hjt8896/STM32-FOC-Driver/Docs/基于 STM32 的有感磁场定向控制.pdf

本文档截选自作者本科毕业论文，仅用于技术交流

## 基于 STM32 的有感磁场定向控制（FOC）系统实现

1.1 引言

磁场定向控制也称 FOC，是一种电机控制方法，本章的设计将使用 FOC 算 法对一个 PMSM 进行矢量控制，在这种控制方式下，电机能够输出很高精度的

力矩和转子位置。

## 1.2 PMSM 数学模型

本节采用旋转坐标系（dq 轴），则 PMSM 的动态特性由公式(1-1)、(1-2)描

述：

d
d | d s | d | e q q

di
v i R L | L i
dt = | + | -ω | (1-1)
( | )

q
q | q s | q | e | d d | f

di
v i R L | L i
dt = | + | +ω | + Ψ | (1-2)
式中 | , d | q v v ——d 轴和 q 轴电压（V）；

, d q
i i ——d 轴和 q 轴电流（A）；

Rs ——定子电阻（Ω ）。

, Ld Lq ——d 轴和 q 轴电感（h）；

## ωe ——电角速度（rad/s）；

Ψ f ——永磁体磁链（Wb）；

对 d

## i 和 q

i 进行前馈解耦：

'd | d | e q q v = v +ω L i | (1-3)
' | ( | )
q | q | e | d d | f v = v -ω L i + Ψ | (1-4)

解耦后的电压方程简化为：

'd
d
d s d

di

## v i R L

dt = | + | (1-5)
' | | q
q | q s | q di

## v i R L

dt = | + | (1-6)

此时，dq 轴电流的传递函数为：

| ' | 1
( )
( )
( ) 1
d | s d
d | d
s i s | R G s
v s | L
s
| R
= | =
+

(1-7)

# 本文档截选自作者本科毕业论文，仅用于技术交流 本文档截选自作者本科毕业论文，仅用于技术交流 本文档截选自作者本科毕业论文，仅用于技术交流

' | 1
( )
( )
( ) 1
q | s q
q | q
s i s | R G s
v s | L
s
| R
= | =
+

(1-8)

### 1.3 磁场定向控制算法架构

FOC 算法主要由 PI 控制器、电流坐标变换、空间矢量 PWM 调制以及转子 位置反馈这几个部分组成，整体控制结构图如图 1-1 所示：

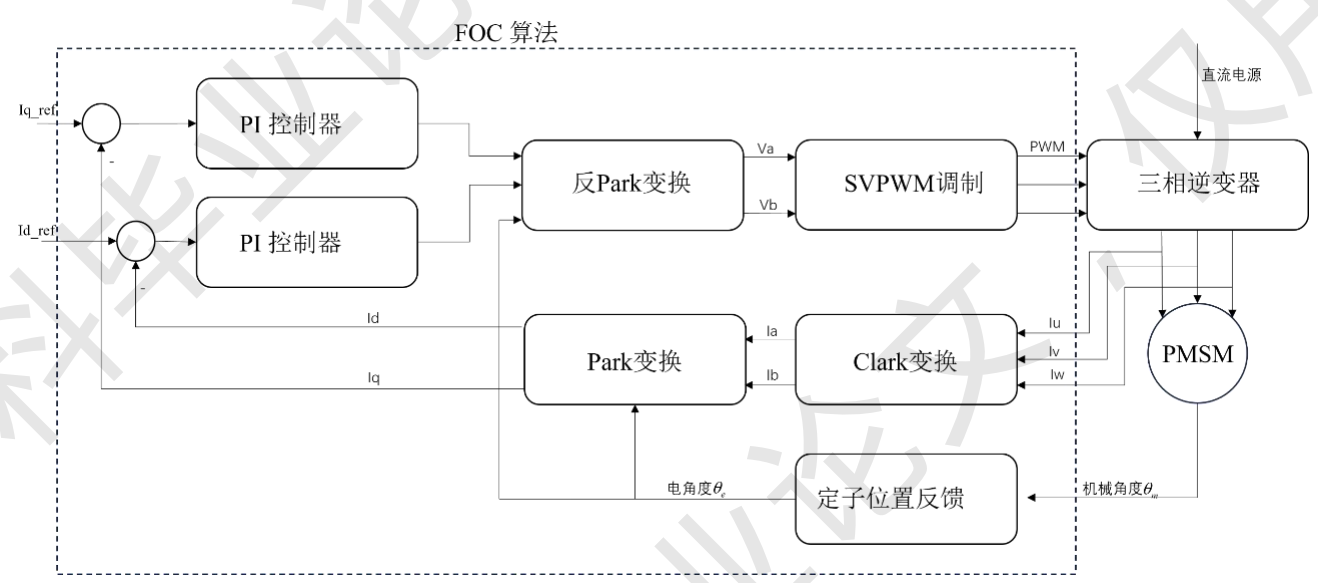
[picture p1: figure]

图 1-1 FOC 算法结构图

### 1.3.1 电流坐标变换

电流坐标变换是 FOC 算法中很重要的步骤。PMSM 的三相电流通过 Clark

变换（幅值不变）：
| 1 | 1
1
2 | 2 | 2
3 | 3 | 3
0
| 2 | 2

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
é | ù - | - | é ù
ê | ú é ù | ê ú = ê | ú ê ú | ê ú
ë û | ê | ú - | ê ú
ê | | | | ú ë û
ë | û
(1-9)
将三相电流转换到两相静止坐标系下的两相电流i ,i α β ，再通过 Park 变换：
cos | sin
sin | cos

d

q

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

(1-10)

将两相电流转换到随电机转子同步旋转的坐标系下的电流 , d q
i i ，为后续转矩电流

和励磁电流的独立控制提供了便利。同时控制器输出的两相电流信号需要通过

## Park 反变换：

cos | sin
sin | cos d
| q
i | i
i | i α

β

θ | θ
θ | θ
é ù é | - | ù é ù
ê ú = ê | | ú ê ú
ë û ë | | û ë û

(1-11)

# 本文档截选自作者本科毕业论文，仅用于技术交流 本文档截选自作者本科毕业论文，仅用于技术交流 本文档截选自作者本科毕业论文，仅用于技术交流

转换到两相静止坐标系下，便于 PWM 的调制。
在仿真软件中搭建电流坐标变换模块如图 1-2 所示，电机三相电流信号用三 个幅值相等，相位依次滞后120

的正弦信号代替，得到仿真结果，其中图 1-3 为
电机三相电流，图 1-4 为 Clark 变换后的电流，图 1-5 为 Park 变换后的 dq 轴电

流。经过电流坐标变换，相互耦合三相电流被解耦为相互独立的转矩电流和励磁 电流。

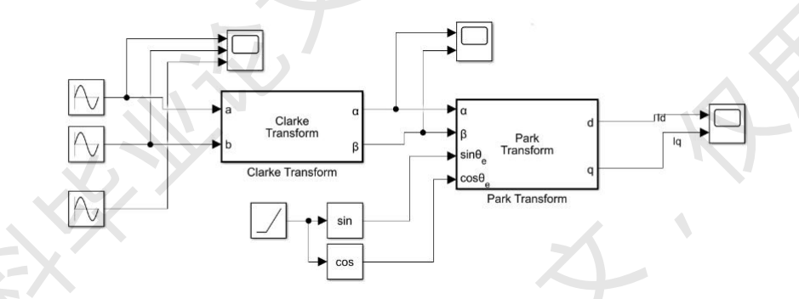
[picture p2: figure]

图 1-2 仿真结构图

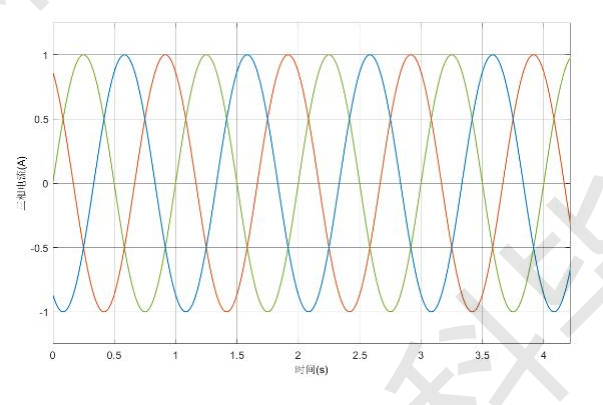
[picture p3: figure]
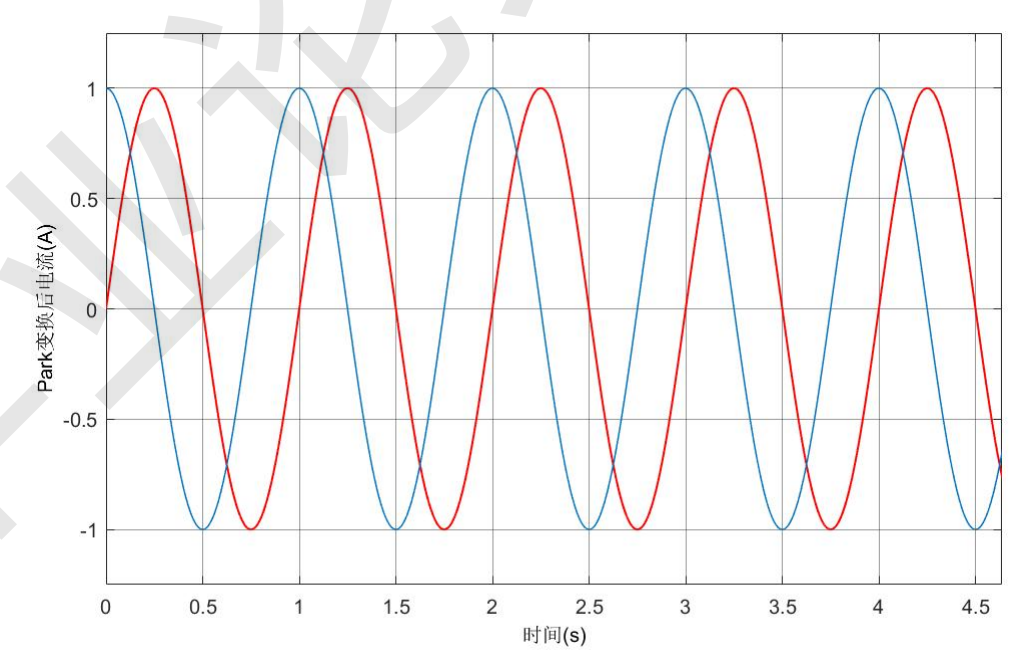
[picture p4: figure]

图 1-3 三相电流 | 图 1-4 Clark 变换后

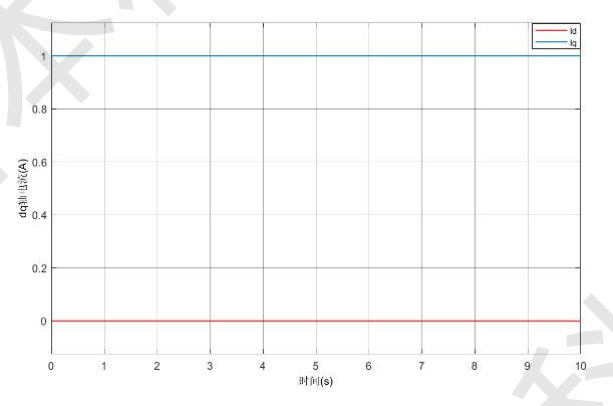
[picture p5: figure]

图 1-5 Park 变换后

## 1.3.2 空间矢量 PWM 调制

空间矢量 PWM 调制是矢量控制系统中至关重要的输出环节，它将经过坐标 变换和电流调节器处理后的两相旋转坐标系(dq 轴)电压指令，通过特定的算法转

换为三相逆变器所需的开关信号，从而实现对电机的高效精确控制。作为连接控 制算法与功率器件的桥梁，SVPWM 通过合理利用电压矢量的空间分布和时序组

# 本文档截选自作者本科毕业论文，仅用于技术交流 本文档截选自作者本科毕业论文，仅用于技术交流 本文档截选自作者本科毕业论文，仅用于技术交流

合，不仅能够显著提高直流母线电压利用率，还能有效降低谐波含量和开关损耗， 是确保矢量控制系统动态性能和稳态精度的关键技术。该调制方法基于电压空间 矢量理论，通过在一个 PWM 周期内合成目标电压矢量，使得电机获得近似圆形

的旋转磁场，从而实现了对交流电机转矩和磁场的精准解耦控制。三相逆变器的 6 个开关管共有 8 种基本开关状态组合(6 个有效矢量+2 个零矢量)，每种开关状 态对应特定的空间电压矢量，作用到 PMSM 上将产生 6 个不同方向的基本磁矢 量。根据这 6 个基本磁矢量的空间分布，将空间划分为 6 个独立的扇区，通过每

个扇区边界的两个基本矢量，线性组合出空间中任意位置的矢量。扇区划分如图
1-6 所示：

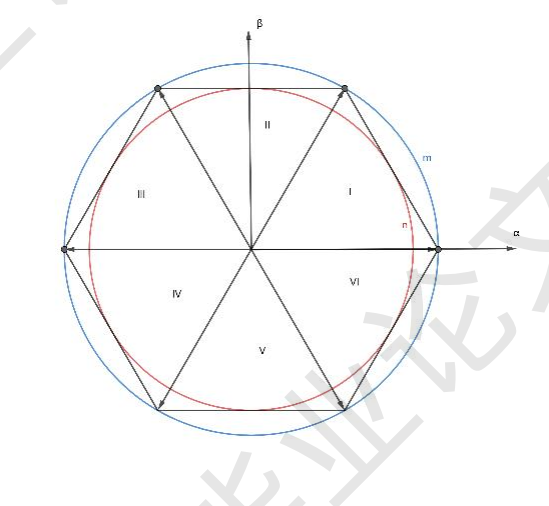
[picture p6: figure]

图 1-6 扇区图
SVPWM 模块的输入是待调制空间电压矢量在两相静止坐标系下的两个坐 标v ,v α β ，首先需要根据这两个电压值判断出该空间电压矢量所处的扇区。首先

定义三个中间变量：

1

2

3

3 | 1
2 | 2
3 | 1
2 | 2

U v

U | v | v
U | v | v
βα | β α | β

ì
ï | =
í | = | -
ï = - | -

î

(1-12)

根据 1 | 2 | 3 U ,U ,U 的符号判断扇区，令：

1

2

3

( )
( )
( )
4 2

## A sig U B sig U C sig U N C B A

ì | =
ï | =
í | = ï
î = | + | +

(1-13)

根据 N 的值得到扇区号后需要计算所处扇区边界基本矢量的线性组合系数。 由图 1-6 可知，终点落在圆 m 与圆 n 之间的矢量无法通过基本矢量线性组合得

# 本文档截选自作者本科毕业论文，仅用于技术交流 本文档截选自作者本科毕业论文，仅用于技术交流 本文档截选自作者本科毕业论文，仅用于技术交流

到，为防止 SVPWM 出现过调制电压失真现象，规定只有处在圆 n 以内，幅值 不大于基本矢量幅值的 0.866 的矢量才能通过线性组合得到。由 PWM（脉宽调

制）平均值等效原理，线性组合系数等于基本矢量作用的时间，而两个零矢量的 作用时间等于载波周期减去基本矢量作用时间。最后根据电压矢量和开关管导通 组合的对应关系，计算出三组互补对称 PWM 的占空比，最终得到的理想 SVPWM

输出信号应该是马鞍波。
在仿真软件中搭建 SVPWM 调试模块如图 1-7 所示，并使用 STM32G431 单 片机进行实物验证，其中输入信号为两个等幅值、相位相差90
- 的正弦信号，输
出为三组 PWM 信号占空比，得到结果如图 1-8 所示：

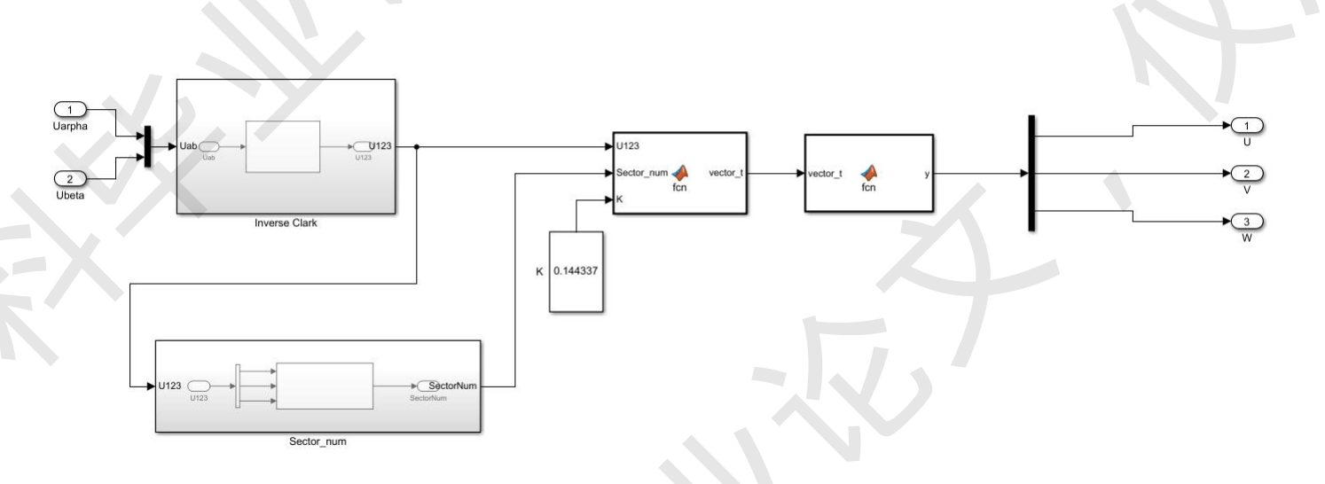
[picture p7: figure]

图 1-7 SVPWM 仿真结构图

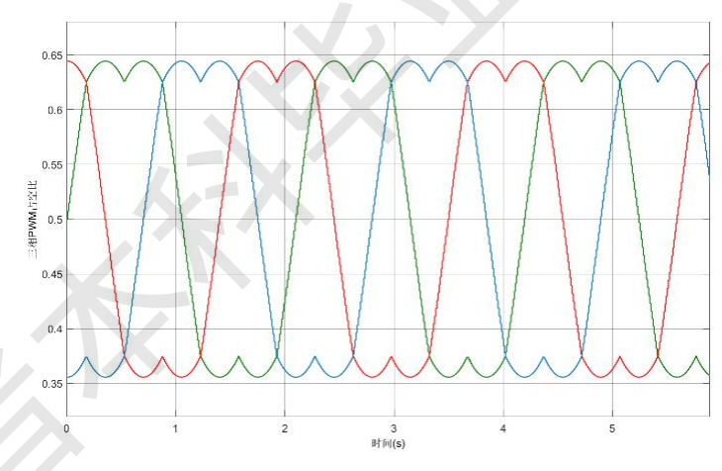
[picture p8: figure]

图 1-8 SVPWM 仿真输出马鞍波

## 1.3.3 PI 控制器参数计算

电流环采用 PI 控制器，设 PI 控制器传递函数：
( )
I c | p

## K G s K

s = +
(1-14)
则系统的闭环传递函数为：

0

0

( ) ( )
( ) 1 ( ) ( )
c

## c G s G s

s

## G s G s

Φ =
+

# 本文档截选自作者本科毕业论文，仅用于技术交流 本文档截选自作者本科毕业论文，仅用于技术交流 本文档截选自作者本科毕业论文，仅用于技术交流

(1-15)
将 1.2 节得到 PMSM 的 dq 轴传递函数代入 0 G (s) ，并假设 Ld = Lq = L ， 于是得

到：

2

1
( )
( )
( | )
p | I s | p | I

## K s K

L s | R K | K
s | s
L | | | L

+
Φ =
+
+ | +
(1-16)
将闭环系统设计为二阶系统，令阻尼比ξ = 0.707 ，此时自然振荡角频率ωn 与
系统带宽有关，取 | 2 n | BW ω = π f ，其中 BW

f 为电流环带宽，一般为 PWM 频率的

0.1 0.2 ，若 PWM 频率取 20KHz，电流环带宽 BW

f 取 2KHz，对比标准二阶系

统 2 | 2 2 n | n s + ξω s +ω ，可以得到：

2

s p

## n R K

L

ξω

+
= | (1-17)
I | 2

n K
L
= ω | (1-18)

解得：

2

2 p | n | s
I | n K | L R
K | | L
| ξω
ω
ì | = | -
í
î =

(1-19)

最后，在实际数字实现时需要进行离散化，可以使用欧拉法或双线性变换。 电流环 PI 参数的推导是按典型 I 型系统设计的。实际调试时需结合带宽需求与

系统稳定性微调参数。

### 1.4 实物验证

### 1.4.1 硬件电路分析

硬件电路主要分为三相逆变器、电流测量网络、微控制器以及辅助电路这几 个主要部分。其中三相逆变器由三相栅极驱动器和 MOSFET 组成，三相栅极驱 动器采用 FD6288Q。由于微控制器的输出电流通常仅为毫安级，无法直接驱动 大功率器件，于是需要栅极驱动器为 MOSFET 的栅极提供足够的驱动电流，以 确保 MOSFET 的快速充放电以实现开关状态的切换。MOSFET 构成三相逆变器 的三相桥臂，由于 MOSFET 的栅极回路存在寄生电感（如 PCB 走线、器件引脚）， 与栅极电容可能形成 LC 谐振电路，需要在 MOSFET 的栅极各串联一个 33 欧姆

的电阻，通过串联电阻增加阻尼系数，可以抑制电压振荡防止误触发或栅极电压 超调。原理图如图 1-9 所示。

# 本文档截选自作者本科毕业论文，仅用于技术交流 本文档截选自作者本科毕业论文，仅用于技术交流 本文档截选自作者本科毕业论文，仅用于技术交流

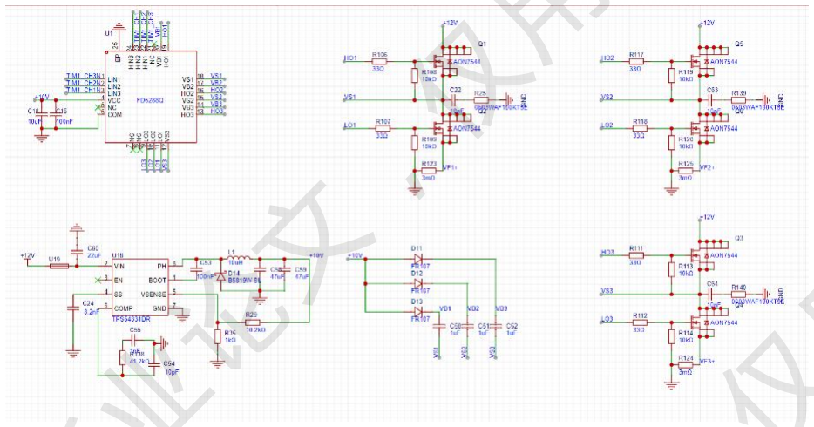
[picture p9: figure]

图 1-9 三相逆变器原理图
电流测量模块由电流采样电阻、运算放大器以及 A\D 转换器构成。本设计 采用低端双电阻电流采样方案，电流采样电阻采用阻值为 3 毫欧，精度为 1%， 功率为 3W 的纯合金贴片电阻，将它串联在三相桥的下桥臂与 GND 之间，它的

作用是将电流信号转换为电压信号，但是由于阻值过小，得到的电压信号通常为 毫伏级，因此需要运算放大器进行放大处理。
本设计采用 STM32G431CBU6 作为微控制器，这款微控制器内部集成了运 算放大器与 12 位 A\D 转换器，但是由于运算放大器使用单电源供电只能放大正 电压信号，需要在外部提供偏置电压，本设计采用电阻分压网络在 MCU 外部提 供 2.08V（放大后）的偏置电压。辅助电路由电源模块与 CAN 收发模块组成， 原理图如图 1-10 和图 1-11 所示。

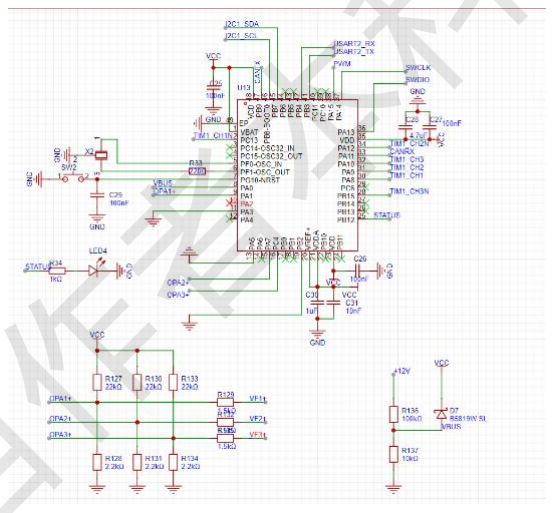
[picture p10: figure]
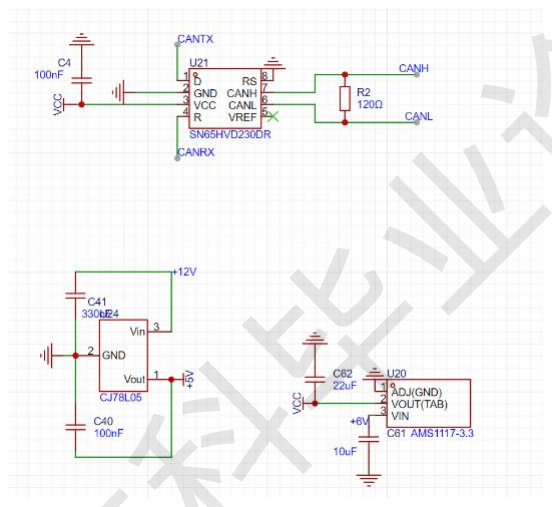
[picture p11: figure]

图 1-10 微控制器 | 图 1-11 辅助电路

### 1.4.2 软件程序设计

软 件 程 序 使 用 C 语 言 编 写 ， 首 先 使 用 STM32 官 方 提 供 的 工 具 STM32CUBEMX 配置 MCU 的外设寄存器，并构建 HAL 库工程模板。需要使用 到的外设有高级控制定时器 TIM1、通用定时器 TIM3、可编程增益运算放大器

# 本文档截选自作者本科毕业论文，仅用于技术交流 本文档截选自作者本科毕业论文，仅用于技术交流 本文档截选自作者本科毕业论文，仅用于技术交流

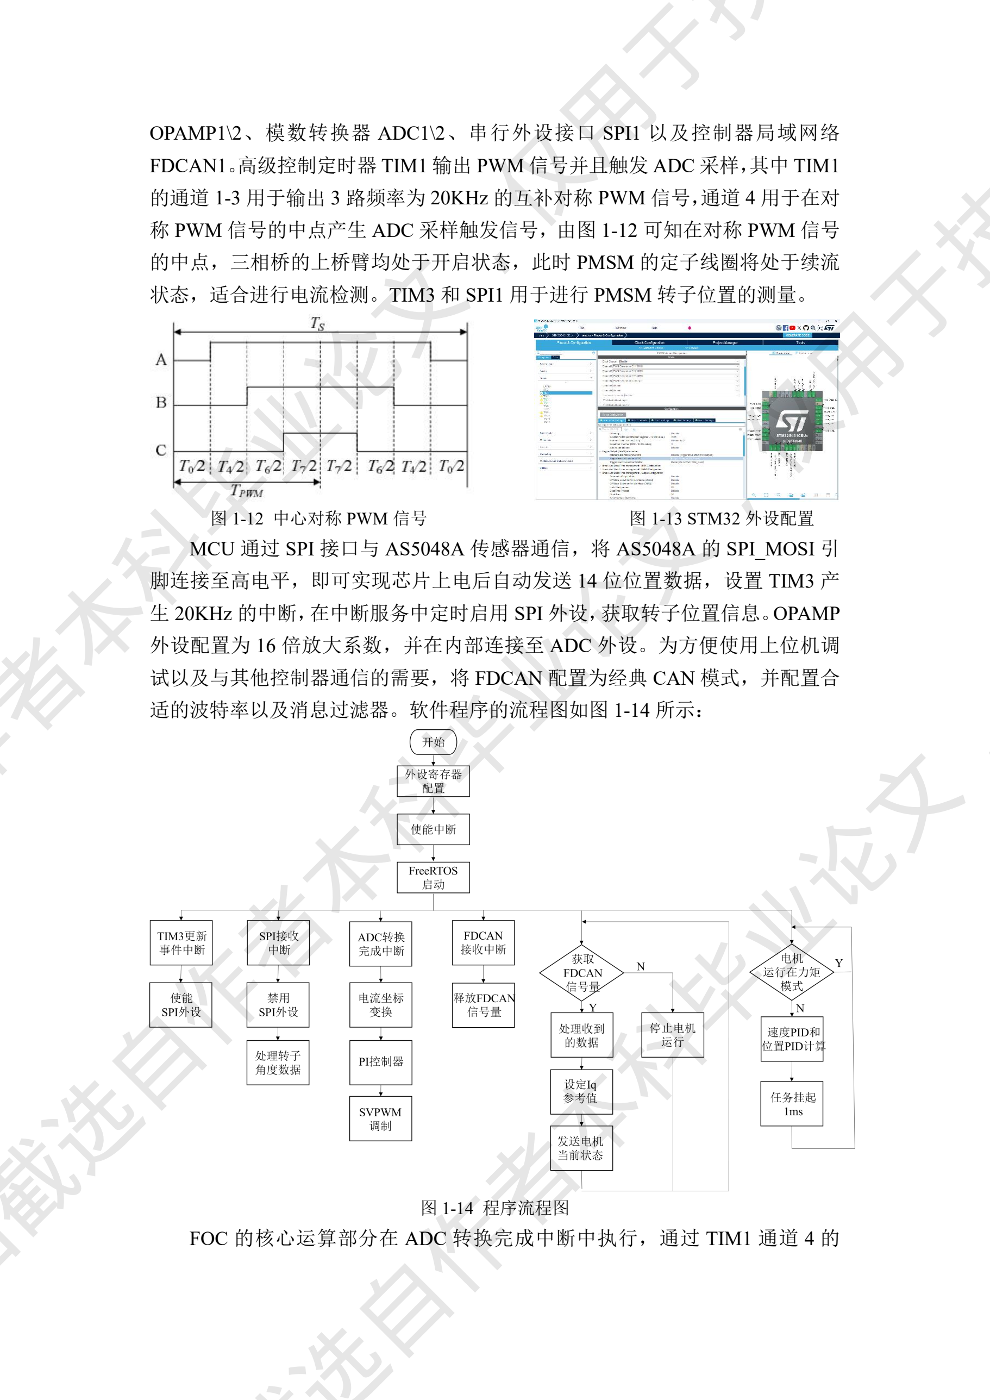
[picture p12: page 8]

OPAMP1\2、模数转换器 ADC1\2、串行外设接口 SPI1 以及控制器局域网络 FDCAN1。高级控制定时器 TIM1 输出 PWM 信号并且触发 ADC 采样，其中 TIM1 的通道 1-3 用于输出 3 路频率为 20KHz 的互补对称 PWM 信号，通道 4 用于在对 称 PWM 信号的中点产生 ADC 采样触发信号，由图 1-12 可知在对称 PWM 信号 的中点，三相桥的上桥臂均处于开启状态，此时 PMSM 的定子线圈将处于续流 状态，适合进行电流检测。TIM3 和 SPI1 用于进行 PMSM 转子位置的测量。

图 1-12 中心对称 PWM 信号 | 图 1-13 STM32 外设配置

## MCU 通过 SPI 接口与 AS5048A 传感器通信，将 AS5048A 的 SPI_MOSI 引

脚连接至高电平，即可实现芯片上电后自动发送 14 位位置数据，设置 TIM3 产 生 20KHz 的中断，在中断服务中定时启用 SPI 外设，获取转子位置信息。OPAMP 外设配置为 16 倍放大系数，并在内部连接至 ADC 外设。为方便使用上位机调 试以及与其他控制器通信的需要，将 FDCAN 配置为经典 CAN 模式，并配置合 适的波特率以及消息过滤器。软件程序的流程图如图 1-14 所示：

图 1-14 程序流程图
FOC 的核心运算部分在 ADC 转换完成中断中执行，通过 TIM1 通道 4 的

# 本文档截选自作者本科毕业论文，仅用于技术交流 本文档截选自作者本科毕业论文，仅用于技术交流 本文档截选自作者本科毕业论文，仅用于技术交流

PWM 信号精确控制电流测量频率为 20KHz，在 ADC 中断服务中，首先清除 ADC

中断寄存器标志位，并读取注入组数据寄存器中的转换数据，然后关闭全局中断， 程序进入临界区，此时获取转子角度位置以及 FreeRTOS 任务中设定电流参考值， 之后退出临界区，开启中断，这样做是为了确保数据的安全传递，避免 ADC 中

断与其他中断以及主进程出现同时操作共享资源，导致数据损坏。之后进行电流 的坐标变换，将三相电流解耦到 dq 轴，并分别进行 d 轴和 q 轴 PI 控制器的计算。 最后将 PI 控制器的输出做 Park 反变换，并通过 SVPWM 模块设定 TIM1 的 3 路 互补对称 PWM 通道的输出比较寄存器。FOC 算法核心代码如图 1-15 所示。

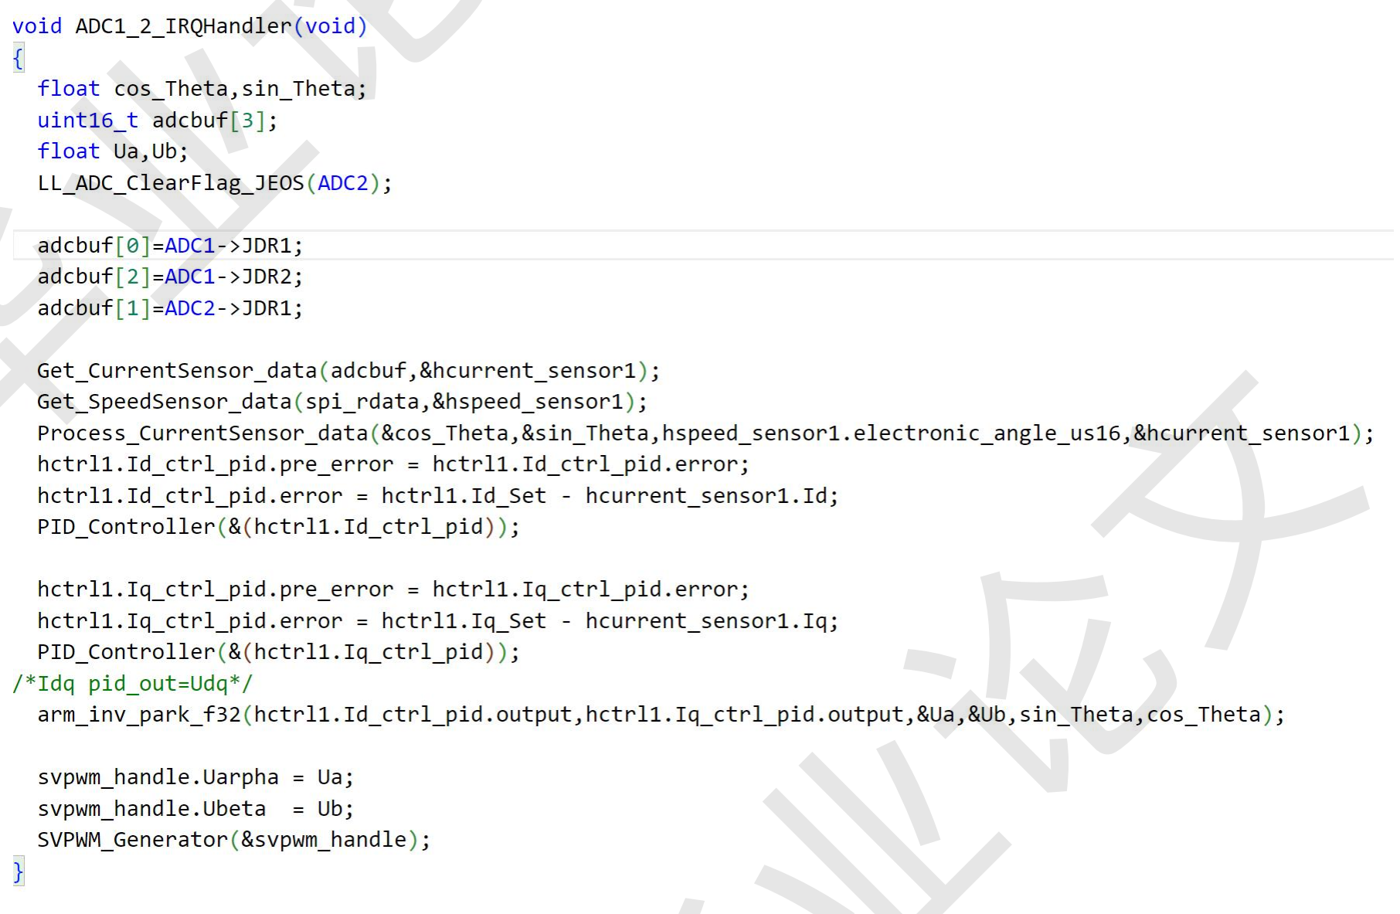
[picture p13: figure]

图 1-15 FOC 核心代码

### 1.4.3 实验测试性能

组装调试完成后的实际系统如图 1-16 所示：

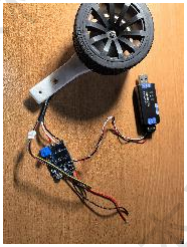
[picture p14: figure]

图 1-16 电机系统实物图
设置电机工作在力矩模式下，上位机通过 CAN 接口与 MCU 通信，上位机 软件设定 Iq 的参考信号为正弦信号，测试电机的跟随特性，结果如图 1-17 所示。 由实验结果可以看出，力矩模式下系统跟踪 10Hz 以内的正弦信号是基本没有误

# 本文档截选自作者本科毕业论文，仅用于技术交流 本文档截选自作者本科毕业论文，仅用于技术交流 本文档截选自作者本科毕业论文，仅用于技术交流

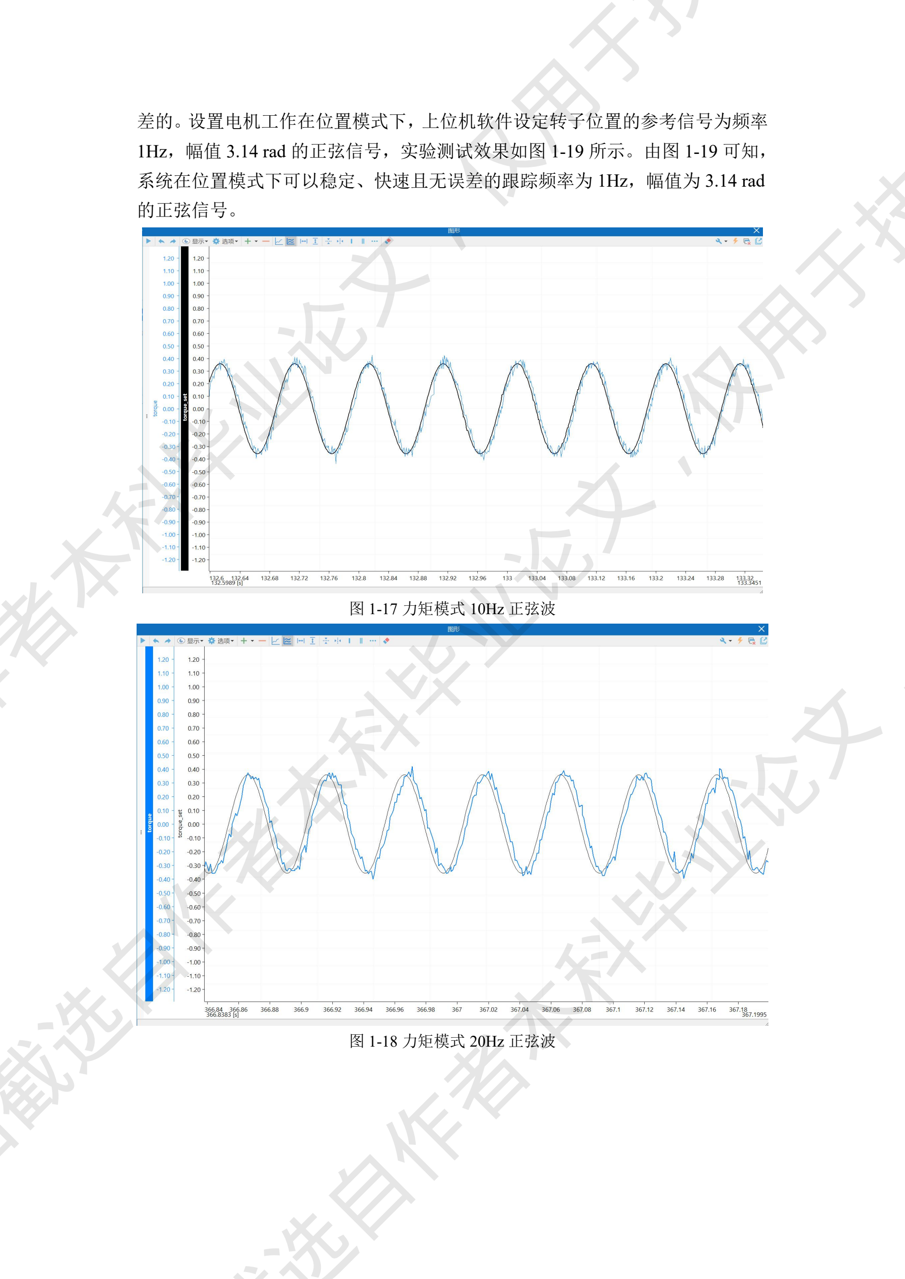
[picture p15: page 10]

差的。设置电机工作在位置模式下，上位机软件设定转子位置的参考信号为频率 1Hz，幅值 3.14 rad 的正弦信号，实验测试效果如图 1-19 所示。由图 1-19 可知， 系统在位置模式下可以稳定、快速且无误差的跟踪频率为 1Hz，幅值为 3.14 rad

的正弦信号。

图 1-17 力矩模式 10Hz 正弦波

图 1-18 力矩模式 20Hz 正弦波

# 本文档截选自作者本科毕业论文，仅用于技术交流 本文档截选自作者本科毕业论文，仅用于技术交流 本文档截选自作者本科毕业论文，仅用于技术交流

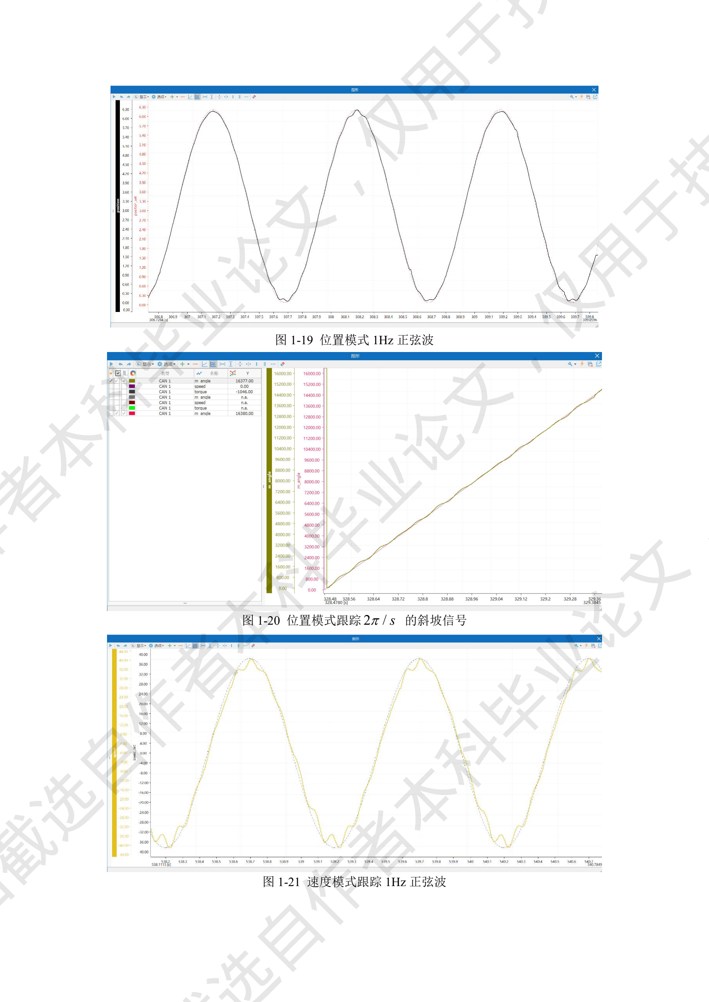
[picture p16: page 11]

图 1-19 位置模式 1Hz 正弦波

图 1-20 位置模式跟踪 2π / s 的斜坡信号

图 1-21 速度模式跟踪 1Hz 正弦波

# 本文档截选自作者本科毕业论文，仅用于技术交流 本文档截选自作者本科毕业论文，仅用于技术交流 本文档截选自作者本科毕业论文，仅用于技术交流

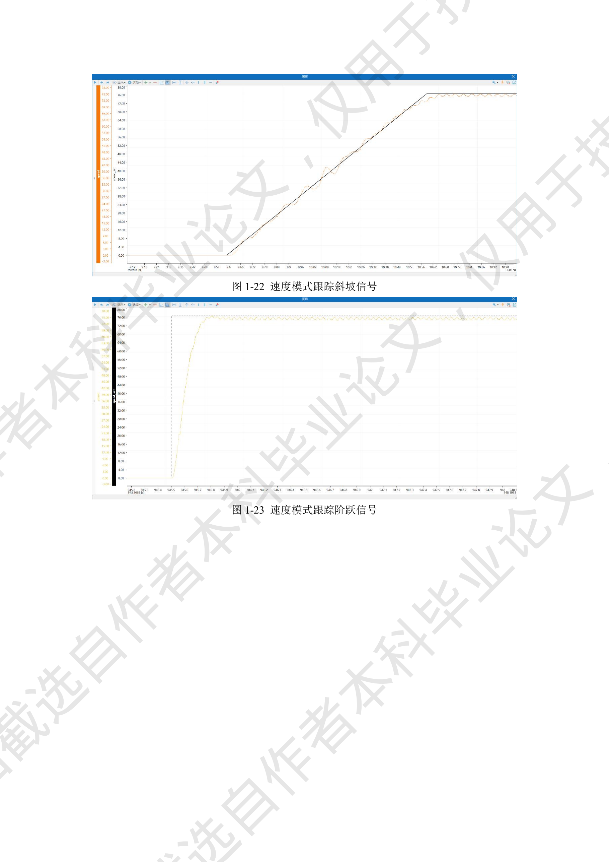
[picture p17: page 12]

图 1-22 速度模式跟踪斜坡信号

图 1-23 速度模式跟踪阶跃信号

# 本文档截选自作者本科毕业论文，仅用于技术交流 本文档截选自作者本科毕业论文，仅用于技术交流 本文档截选自作者本科毕业论文，仅用于技术交流
