hjt8896/STM32-FOC-Driver/Hardware/SCH_Schematic1_2026-02-28.pdf

# HO3 13 VB3 14 VS2 15 HO2 16 VB2 17 VS1 18

# 0603WAF100KT5EGND

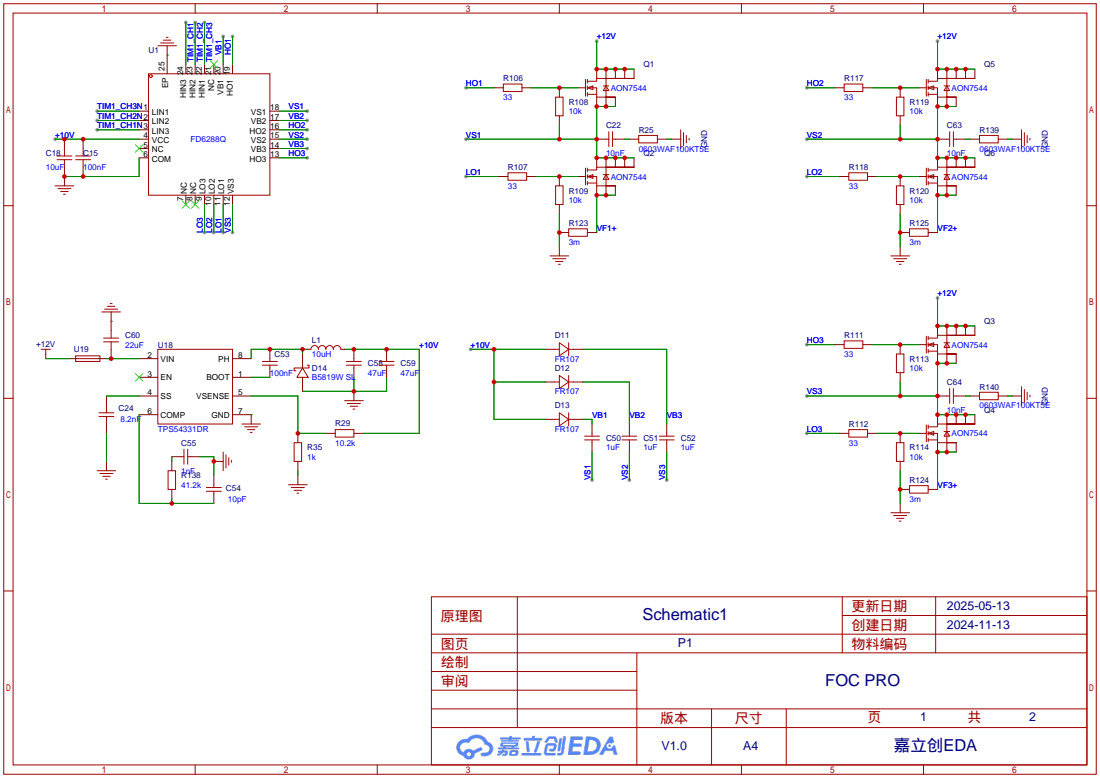
[picture p18: page 1]

# VF3+CANTX

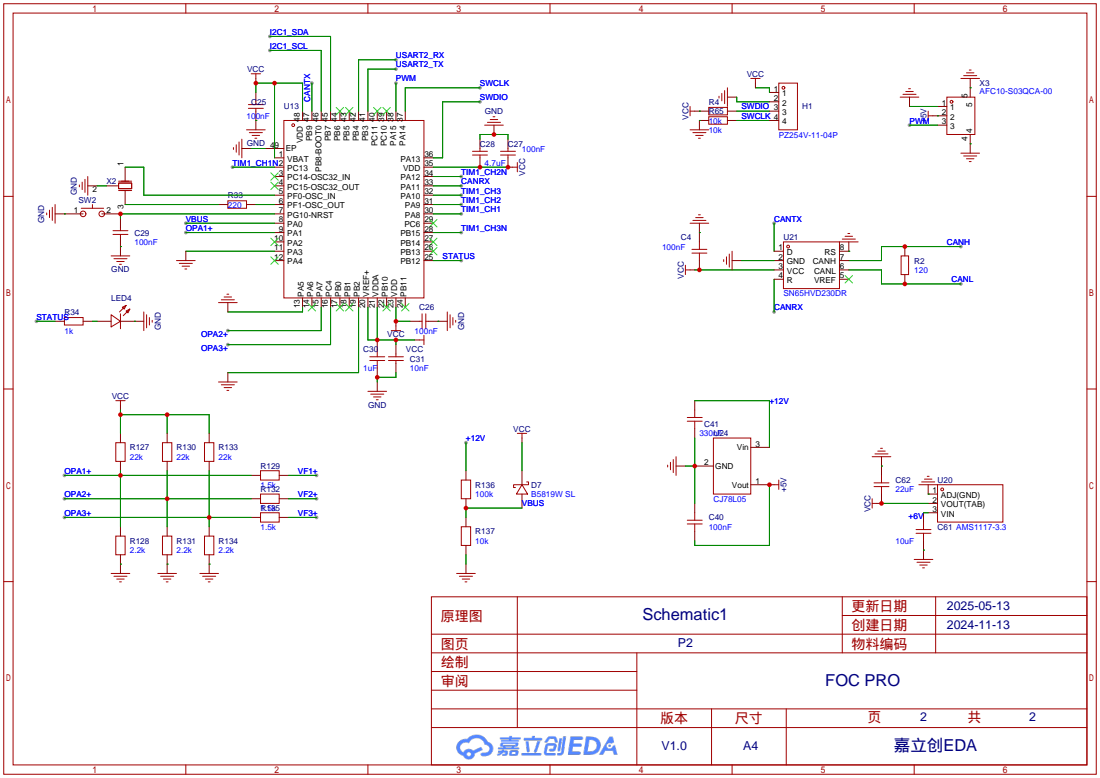
[picture p19: page 2]

PB12 25 PB¹¹ 24 VDD 23 PB¹⁰ 22 VDDA 21 VREF+ 20 PB² 19 PB¹ 18 PB⁰ 17 PC⁴ 16 PA⁷ 15 PA⁶ 14 PA⁵ 13
