hjt8896/STM32-FOC-Driver/(list of files, drawings)

Other design files:
Hardware/ProProject_FOC PRO_2025-05-28.epro
