hjt8896/STM32-FOC-Driver/(commit log)

2026-03-02 Create 基于 STM32 的有感磁场定向控制.pdf
2026-03-02 Update hardware stack in README
    Added 3510 cloud platform brushless motor to hardware stack.
